Supercap2F/Smart-Watch/KiCAD/SmartWatchBOM.xls

Smart Watch BOM
Ref | ESR | Value | Type | Volts | Part No. | DigiKey Part No. | Qt. | Qt. Ex. | Price Ea. | Price Total | Package
BT1 |  | LiPoly 1S1P |  |  |  | - | 1 |  | $0.00 | $0.00 | 603
C36 C37 |  | 9p1 |  |  |  | 1276-2353-1-ND | 2 |  | $0.10 | $0.20 | 603
C34 C35 |  | 15p |  |  |  | 1276-1296-1-ND | 2 |  | $0.10 | $0.20 | 603
C4 |  | 27p |  |  |  | 1276-1086-1-ND | 1 |  | $0.10 | $0.10 | 603
C12 C13 |  | 47p |  |  |  | 1276-1037-1-ND | 2 |  | $0.10 | $0.20 | 603
C5 |  | 180p |  |  |  | 1276-1255-1-ND | 1 |  | $0.10 | $0.10 | 603
C6 C10 C11 C14 C16 C20 C21 C22 C23 C26 C27 C28 C29 C30 C31 C33 |  | 100n |  |  |  | 311-1343-1-ND | 16 | 9 | $0.01 | $0.32 | 603
C7 C18 C24 |  | 1u |  |  |  | 311-1372-1-ND | 3 | 7 | $0.03 | $0.33 | 603
C2 C9 C19 C25 |  | 4.7u |  |  |  | 478-8656-1-ND | 4 | 1 | $0.77 | $3.85 | 603
C17 |  | 4.7u | tan | 25 |  | 478-8508-1-ND | 1 | 1 | $0.86 | $1.72 | 805
C1 C3 C15 |  | 10u |  |  |  | 718-1118-1-ND | 3 | 1 | $0.31 | $1.24 | 1206
C8 |  | 10u | X5R |  |  | 1276-6457-1-ND | 1 | 1 | $0.10 | $0.20 | 805
C32 | <3R | 10u | tan | 6 |  | 478-8193-1-ND | 1 | 1 | $0.34 | $0.68 | 1206
I1 |  | 10uH |  |  |  | 445-6396-1-ND | 1 | 8 | $0.14 | $1.26
I2 |  | 10uH |  |  |  | 445-6396-1-ND | 1 |  | $0.14 | $0.14
M1 |  | MOTOR |  |  |  |  | 1 |  | $0.00 | $0.00
P1 |  | CONN_5 |  |  |  | 609-4613-1-ND | 1 | 1 | $0.46 | $0.92
Q1 |  | NPN |  |  |  |  | 1 |  | $0.00 | $0.00
R2 R3 |  | 0R |  |  | have some |  | 2 |  | $0.00 | $0.00 | 603
R8 R9 |  | 27R |  |  |  | 311-27GRCT-ND | 2 | 8 | $0.01 | $0.11 | 603
R1 R14 |  | 1K |  |  |  | 311-1.0KGRCT-ND | 2 | 8 | $0.01 | $0.11 | 603
R7 |  | 2K8 |  |  |  | 311-2.80KHRCT-ND | 1 | 9 | $0.01 | $0.14 | 603
R10 |  | 4K7 |  |  |  | 311-4.7KGRCT-ND | 1 | 9 | $0.01 | $0.11 | 603
R11 R13 R15 R16 R17 R18 R19 |  | 10K |  |  |  | 311-10KGRCT-ND | 7 | 3 | $0.01 | $0.11 | 603
R6 |  | 27K |  |  |  | 311-27KGRCT-ND | 1 | 9 | $0.01 | $0.12 | 603
R5 |  | 100K |  |  |  | 311-100KGRCT-ND | 1 | 9 | $0.01 | $0.11 | 603
R4 R12 |  | 560K |  |  |  | A102294CT-ND | 2 | 1 | $0.63 | $1.89 | 603
SW1 SW2 SW3 SW4 |  | SW_PUSH |  |  |  | 732-7059-1-ND | 4 | 2 | $0.54 | $3.24
TP1 TP2 TP3 TP4 TP5 TP6 TP7 TP8 TP9 TP10 TP11 |  | TP |  |  | Free! |  | 11 |  | $0.00 | $0.00
U1 |  | BQ25010 |  |  |  | 296-17639-1-ND | 1 |  | $3.87 | $3.87
U2 |  | MIC2290 |  |  |  | 576-1076-1-ND | 1 |  | $0.82 | $0.82
U4 |  | EROLED015-1 |  |  | get from buydisplays.com |  | 1 |  | $0.00 | $0.00
U5 |  | FXOS8700CQ |  |  |  | FXOS8700CQR1CT-ND | 1 |  | $2.63 | $2.63
U6 |  | PIC32MX370F512H |  |  | buy from microchip $14+ |  | 1 |  | $0.00 | $0.00
U3 |  | FT201X |  |  |  | 768-1131-1-ND | 1 |  | $2.30 | $2.30
X2 |  | 32.768KHz |  |  | 9HT10-32.768KBZC-T | 887-2604-1-ND | 1 | 1 | $0.59 | $1.18
X1 |  | 25MHz |  |  | ABM8-25.000MHZ-D2Y-T | 535-13419-1-ND | 1 | 1 | $0.46 | $0.92
 |  |  |  |  |  |  |  |  | Total: | $29.12
