Supercap2F/Smart-Watch/3D-Models/BoN-Jig/JigPrint001.stl

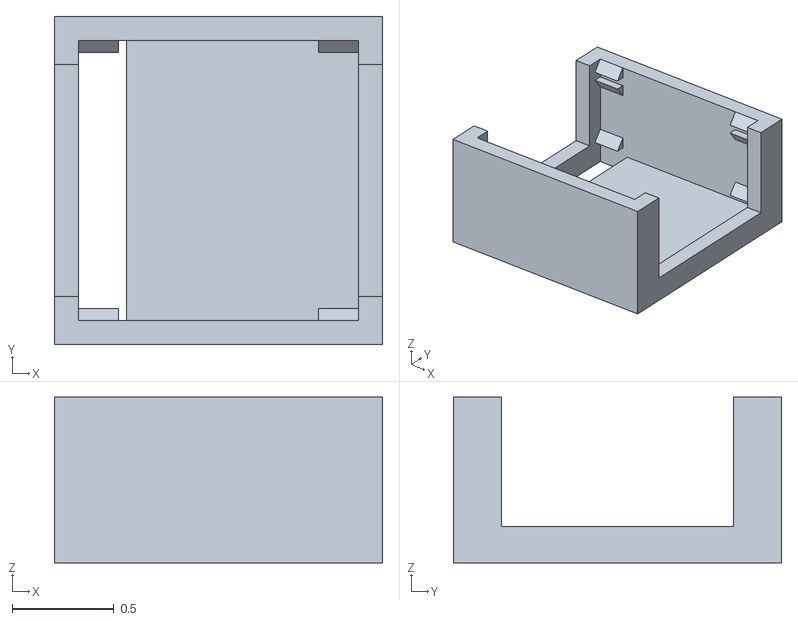
[picture p1: CAD file, 2016-07-14]
3D-Models/BoN-Jig/JigPrint001.stl
1.61 x 1.61 x 0.815
