Supercap2F/Smart-Watch/3D-Models/BoN-Jig/JigPrint001 - Jig (repaired).stl

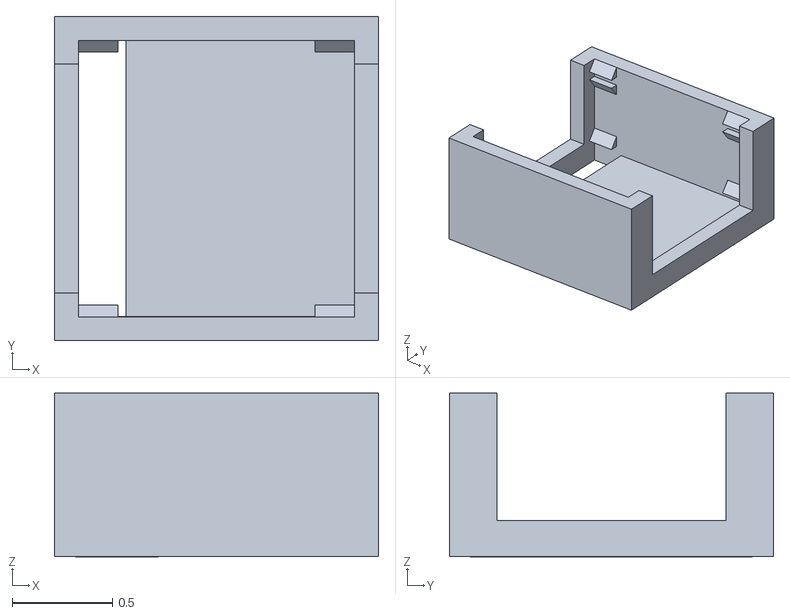
[picture p3: CAD file, 2016-07-14]
3D-Models/BoN-Jig/JigPrint001 - Jig (repaired).stl
1.62 x 1.62 x 0.816
