Supercap2F/Smart-Watch/(list of files, cad)

Other CAD files:
3D-Models/BoN-Jig/Jig.skp
