Supercap2F/Smart-Watch/KiCAD/SmartWatch.pdf

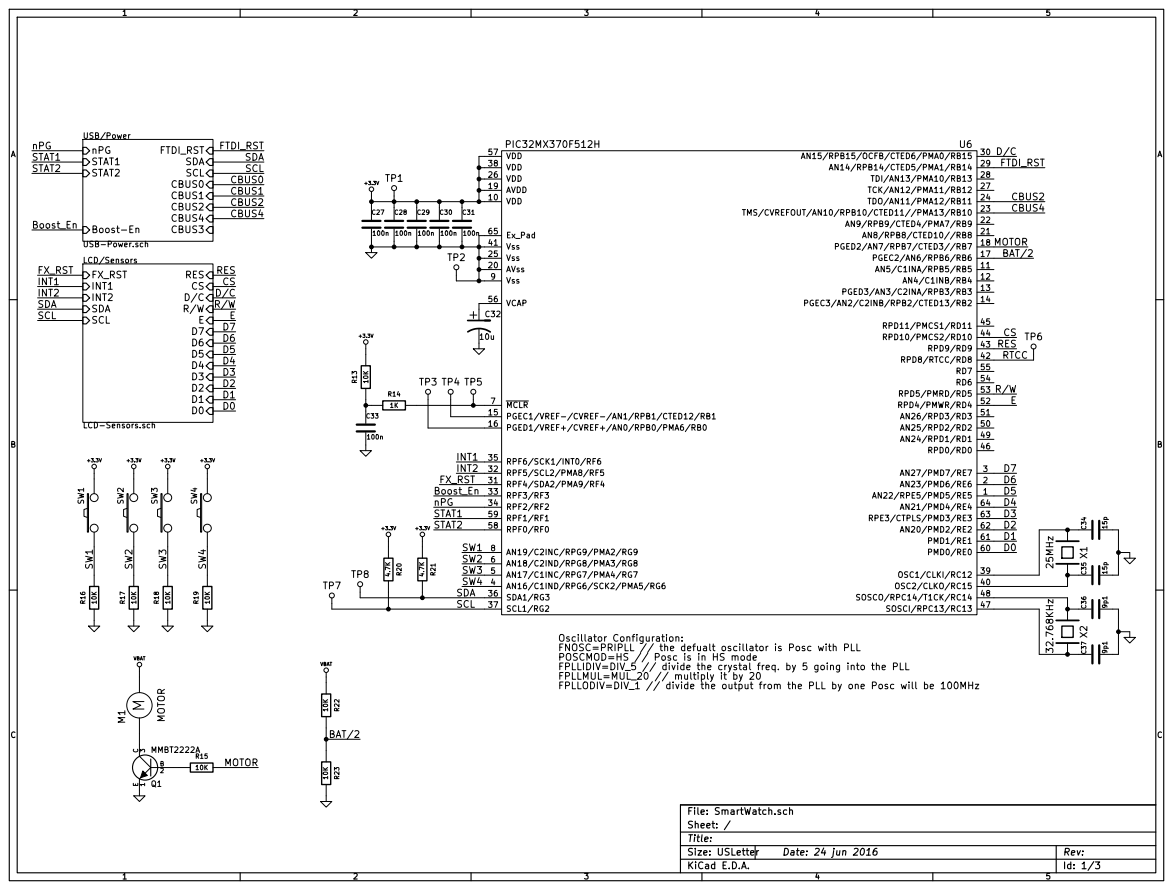
[picture p4: page 1]

Oscillator Configuration:
FNOSC=PRIPLL // the defualt oscillator is Posc with PLL
POSCMOD=HS // Posc is in HS mode
FPLLIDIV=DIV_5 // divide the crystal freq. by 5 going into the PLL
FPLLMUL=MUL_20 // multiply it by 20

Id: 1/3 Title: File: SmartWatch.sch
Sheet: /

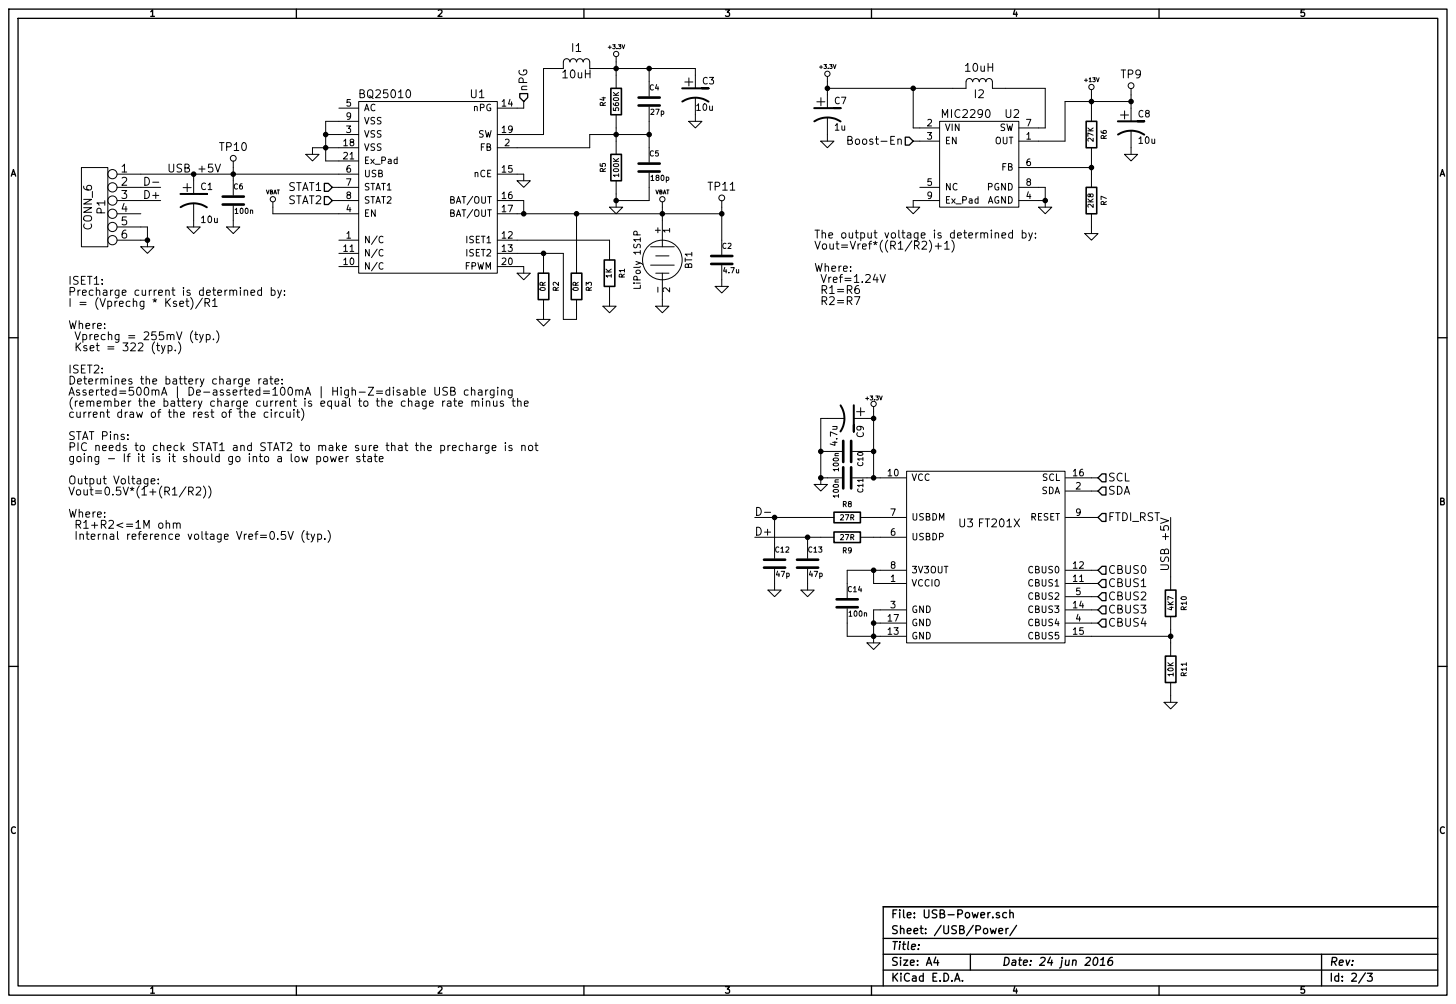
[picture p5: page 2]

+3.3V The output voltage is determined by:

Precharge current is determined by:
I = (Vprechg * Kset)/R1 Where:

Vprechg = 255mV (typ.)
Kset = 322 (typ.)
ISET2:
Determines the battery charge rate:
Asserted=500mA | De-asserted=100mA | High-Z=disable USB charging
(remember the battery charge current is equal to the chage rate minus the
current draw of the rest of the circuit)
STAT Pins:
PIC needs to check STAT1 and STAT2 to make sure that the precharge is not
going - If it is it should go into a low power state
Output Voltage:
Vout=0.5V*(1+(R1/R2)) Where:

Id: 2/3 Title: File: USB-Power.sch
Sheet: /USB/Power/

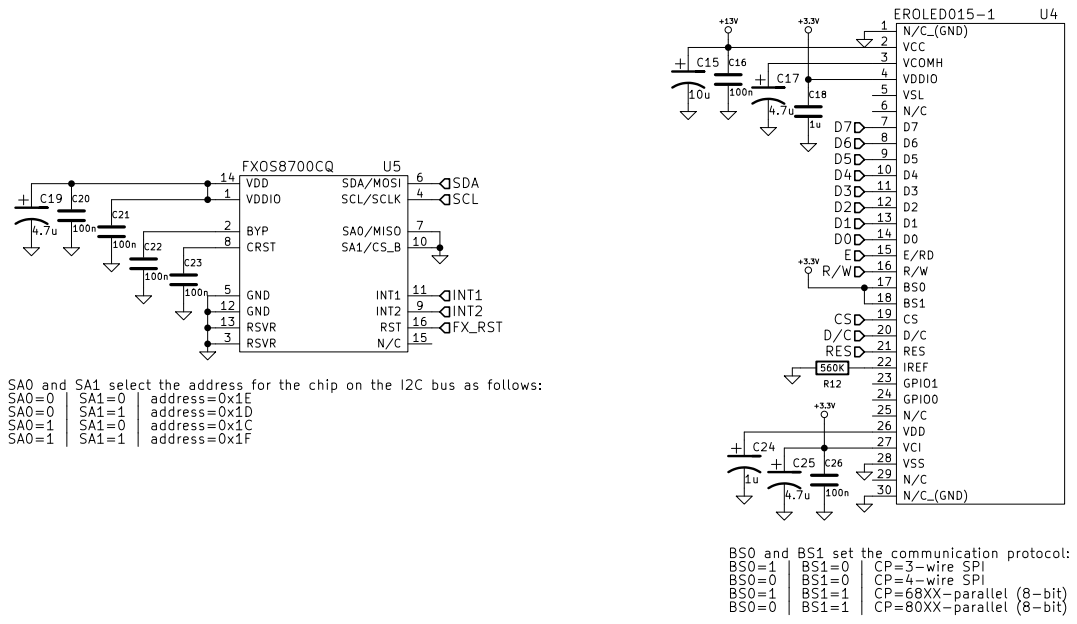
[picture p6: page 3]

SA0 and SA1 select the address for the chip on the I2C bus as follows:
SA0=0 | SA1=0 | address=0x1E
SA0=0 | SA1=1 | address=0x1D
SA0=1 | SA1=0 | address=0x1C
SA0=1 | SA1=1 | address=0x1F

Id: 3/3 Title: File: LCD-Sensors.sch
Sheet: /LCD/Sensors/
