Supercap2F/Smart-Watch/KiCAD/SmartWatch.kicad_pcb

## KiCad design KiCAD/SmartWatch.kicad_pcb (2016-07-19)

Schematic: SmartWatch.sch

Parts:
C27, C28, C29, C30, C31, C33: 100n
C32: 10u; Voltage 6
C34, C35: 15p
C36, C37: 9p1
M1: MOTOR
Q1: MMBT2222A
R13, R15, R16, R17, R18, R19, R22, R23: 10K
R14: 1K
R20, R21: 4.7K
SW1, SW2, SW3, SW4: SW_PUSH
TP1, TP2, TP3, TP4, TP5, TP6, TP7, TP8: TP
U6: PIC32MX370F512H
X1: 25MHz
X2: 32.768KHz

Connections:
+3.3V: C27.1, C28.1, C29.1, C30.1, C31.1, R13.2, R20.1, R21.1, SW1.2, SW2.2, SW3.2, SW4.2, TP1.1, U6.10 (VDD), U6.19 (AVDD), U6.26 (VDD), U6.38 (VDD), U6.57 (VDD); also elsewhere on the board
/BAT/2: R22.2, R23.1, U6.17 (PGEC2/AN6/RPB6/RB6)
/LCD/Sensors/CS: U6.44 (RPD10/PMCS2/RD10); also elsewhere on the board
/LCD/Sensors/D0: U6.60 (PMD0/RE0); also elsewhere on the board
/LCD/Sensors/D1: U6.61 (PMD1/RE1); also elsewhere on the board
/LCD/Sensors/D2: U6.62 (AN20/PMD2/RE2); also elsewhere on the board
/LCD/Sensors/D3: U6.63 (RPE3/CTPLS/PMD3/RE3); also elsewhere on the board
/LCD/Sensors/D4: U6.64 (AN21/PMD4/RE4); also elsewhere on the board
/LCD/Sensors/D5: U6.1 (AN22/RPE5/PMD5/RE5); also elsewhere on the board
/LCD/Sensors/D6: U6.2 (AN23/PMD6/RE6); also elsewhere on the board
/LCD/Sensors/D7: U6.3 (AN27/PMD7/RE7); also elsewhere on the board
/LCD/Sensors/D/C: U6.30 (AN15/RPB15/OCFB/CTED6/PMA0/RB15); also elsewhere on the board
/LCD/Sensors/E: U6.52 (RPD4/PMWR/RD4); also elsewhere on the board
/LCD/Sensors/FX_RST: U6.31 (RPF4/SDA2/PMA9/RF4); also elsewhere on the board
/LCD/Sensors/INT1: U6.35 (RPF6/SCK1/INT0/RF6); also elsewhere on the board
/LCD/Sensors/INT2: U6.32 (RPF5/SCL2/PMA8/RF5); also elsewhere on the board
/LCD/Sensors/R/W: U6.53 (RPD5/PMRD/RD5); also elsewhere on the board
/LCD/Sensors/RES: U6.43 (RPD9/RD9); also elsewhere on the board
/LCD/Sensors/SCL: R20.2, TP7.1, U6.37 (SCL1/RG2); also elsewhere on the board
/LCD/Sensors/SDA: R21.2, TP8.1, U6.36 (SDA1/RG3); also elsewhere on the board
/MOTOR: R15.2, U6.18 (PGED2/AN7/RPB7/CTED3//RB7)
/RTCC: TP6.1, U6.42 (RPD8/RTCC/RD8)
/SW1: R16.2, SW1.1, U6.8 (AN19/C2INC/RPG9/PMA2/RG9)
/SW2: R17.2, SW2.1, U6.6 (AN18/C2IND/RPG8/PMA3/RG8)
/SW3: R18.2, SW3.1, U6.5 (AN17/C1INC/RPG7/PMA4/RG7)
/SW4: R19.2, SW4.1, U6.4 (AN16/C1IND/RPG6/SCK2/PMA5/RG6)
/USB/Power/Boost-En: U6.33 (RPF3/RF3); also elsewhere on the board
/USB/Power/CBUS2: U6.24 (TDO/AN11/PMA12/RB11); also elsewhere on the board
/USB/Power/CBUS4: U6.23 (TMS/CVREFOUT/AN10/RPB10/CTED11//PMA13/R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); also elsewhere on the board
/USB/Power/FTDI_RST: U6.29 (AN14/RPB14/CTED5/PMA1/RB14); also elsewhere on the board
/USB/Power/STAT1: U6.59 (RPF1/RF1); also elsewhere on the board
/USB/Power/STAT2: U6.58 (RPF0/RF0); also elsewhere on the board
/USB/Power/nPG: U6.34 (RPF2/RF2); also elsewhere on the board
GND: C27.2, C28.2, C29.2, C30.2, C31.2, C32.2, C33.2, C34.2, C35.2, C36.2, C37.2, Q1.1 (E), R16.1, R17.1, R18.1, R19.1, R23.2, TP2.1, U6.9 (Vss), U6.20 (AVss), U6.25 (Vss), U6.41 (Vss), U6.65 (Ex_Pad), X1.3, X1.4; also elsewhere on the board
unnamed: C34.1, U6.39 (OSC1/CLKI/RC12), X1.2
unnamed: C35.1, U6.40 (OSC2/CLKO/RC15), X1.1
unnamed: TP3.1, U6.16 (PGED1/VREF+/CVREF+/AN0/RPB0/PMA6/RB0)
unnamed: TP4.1, U6.15 (PGEC1/VREF-/CVREF-/AN1/RPB1/CTED12/RB1)
unnamed: C33.1, R13.1, R14.1
unnamed: C36.1, U6.48 (SOSCO/RPC14/T1CK/RC14), X2.2
unnamed: C37.1, U6.47 (SOSCI/RPC13/RC13), X2.1
unnamed: Q1.2 (B), R15.1
unnamed: M1.1, Q1.3 (C)
unnamed: R14.2, TP5.1, U6.7 (~MCLR)
unnamed: C32.1, U6.56 (VCAP)
VBAT: R22.1; also elsewhere on the board

Notes on the sheet:
Oscillator Configuration: FNOSC=PRIPLL // the defualt oscillator is Posc with PLL POSCMOD=HS // Posc is in HS mode FPLLIDIV=DIV_5 // divide the crystal freq. by 5 going into the PLL FPLLMUL=MUL_20 // multiply it by 20 FPLLODIV=DIV_1 // divide the output from the PLL by one Posc will be 100MHz

Schematic: USB-Power.sch

Parts:
BT1: LiPoly 1S1P
C1, C3, C8: 10u
C2, C9: 4.7u
C4: 27p
C5: 180p
C6, C10, C11, C14: 100n
C7: 1u
C12, C13: 47p
I1: 10uH
I2: 10uH
P1: CONN_6
R1: 1K
R2, R3: 0R
R4: 560K
R5: 100K
R6: 27K
R7: 2K8
R8, R9: 27R
R10: 4K7
R11: 10K
TP9, TP10, TP11: TP
U1: BQ25010
U2: MIC2290
U3: FT201X

Connections:
+3.3V: C3.1, C4.1, C7.1, C9.1, C10.1, C11.1, I1.2, I2.1, R4.2, U2.2 (VIN), U3.10 (VCC); also elsewhere on the board
+13V: C8.1, R6.1, TP9.1, U2.1 (OUT); also elsewhere on the board
/LCD/Sensors/SCL: U3.16 (SCL); also elsewhere on the board
/LCD/Sensors/SDA: U3.2 (SDA); also elsewhere on the board
/USB/Power/Boost-En: U2.3 (EN); also elsewhere on the board
/USB/Power/CBUS2: U3.5 (CBUS2); also elsewhere on the board
/USB/Power/CBUS4: U3.4 (CBUS4); also elsewhere on the board
/USB/Power/D+: C13.1, P1.3, R9.1
/USB/Power/D-: C12.1, P1.2, R8.1
/USB/Power/FTDI_RST: U3.9 (RESET); also elsewhere on the board
/USB/Power/STAT1: U1.7 (STAT1); also elsewhere on the board
/USB/Power/STAT2: U1.8 (STAT2); also elsewhere on the board
/USB/Power/USB +5V: C1.1, C6.1, P1.1, R10.2, TP10.1, U1.6 (USB)
/USB/Power/nPG: U1.14 (nPG); also elsewhere on the board
GND: BT1.2 (-), C1.2, C2.2, C3.2, C5.2, C6.2, C7.2, C8.2, C9.2, C10.2, C11.2, C12.2, C13.2, C14.2, P1.5, P1.6, R1.2, R2.2, R5.1, R7.2, R11.1, U1.3 (VSS), U1.9 (VSS), U1.15 (nCE), U1.18 (VSS), U1.20 (FPWM), U1.21 (Ex_Pad), U2.4 (AGND), U2.8 (PGND), U2.9 (Ex_Pad), U3.3 (GND), U3.13 (GND), U3.17 (GND); also elsewhere on the board
unnamed: I1.1, U1.19 (SW)
unnamed: C4.2, C5.1, R4.1, R5.2, U1.2 (FB)
unnamed: I2.2, U2.7 (SW)
unnamed: R2.1, R3.2, U1.13 (ISET2)
unnamed: R1.1, U1.12 (ISET1)
unnamed: R10.1, R11.2, U3.15 (CBUS5)
unnamed: C14.1, U3.1 (VCCIO), U3.8 (3V3OUT)
unnamed: R9.2, U3.6 (USBDP)
unnamed: R6.2, R7.1, U2.6 (FB)
unnamed: R8.2, U3.7 (USBDM)
VBAT: BT1.1 (+), C2.1, R3.1, TP11.1, U1.4 (EN), U1.16 (BAT/OUT), U1.17 (BAT/OUT); also elsewhere on the board

Notes on the sheet:
ISET1: Precharge current is determined by: I = (Vprechg * Kset)/R1 Where: Vprechg = 255mV (typ.) Kset = 322 (typ.) ISET2: Determines the battery charge rate: Asserted=500mA | De-asserted=100mA | High-Z=disable USB charging (remember the battery charge current is equal to the chage rate minus the cu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
The output voltage is determined by: Vout=Vref*((R1/R2)+1) Where: Vref=1.24V R1=R6 R2=R7

Schematic: LCD-Sensors.sch

Parts:
C15: 10u
C16, C20, C21, C22, C23, C26: 100n
C17: 4.7u; Voltage 25
C18, C24: 1u
C19, C25: 4.7u
R12: 560K
U4: EROLED015-1
U5: FXOS8700CQ

Connections:
+3.3V: C18.1, C25.1, C26.1, U4.4 (VDDIO), U4.17 (BS0), U4.18 (BS1), U4.27 (VCI); also elsewhere on the board
+13V: C15.1, C16.1, U4.2 (VCC); also elsewhere on the board
/LCD/Sensors/CS: U4.19 (CS); also elsewhere on the board
/LCD/Sensors/D0: U4.14 (D0); also elsewhere on the board
/LCD/Sensors/D1: U4.13 (D1); also elsewhere on the board
/LCD/Sensors/D2: U4.12 (D2); also elsewhere on the board
/LCD/Sensors/D3: U4.11 (D3); also elsewhere on the board
/LCD/Sensors/D4: U4.10 (D4); also elsewhere on the board
/LCD/Sensors/D5: U4.9 (D5); also elsewhere on the board
/LCD/Sensors/D6: U4.8 (D6); also elsewhere on the board
/LCD/Sensors/D7: U4.7 (D7); also elsewhere on the board
/LCD/Sensors/D/C: U4.20 (D/C); also elsewhere on the board
/LCD/Sensors/E: U4.15 (E/RD); also elsewhere on the board
/LCD/Sensors/FX_RST: U5.16 (RST); also elsewhere on the board
/LCD/Sensors/INT1: U5.11 (INT1); also elsewhere on the board
/LCD/Sensors/INT2: U5.9 (INT2); also elsewhere on the board
/LCD/Sensors/R/W: U4.16 (R/W); also elsewhere on the board
/LCD/Sensors/RES: U4.21 (RES); also elsewhere on the board
/LCD/Sensors/SCL: U5.4 (SCL/SCLK); also elsewhere on the board
/LCD/Sensors/SDA: U5.6 (SDA/MOSI); also elsewhere on the board
GND: C15.2, C16.2, C17.2, C18.2, C19.2, C20.2, C21.2, C22.2, C23.2, C24.2, C25.2, C26.2, R12.1, U4.1 (N/C_(GND)), U4.28 (VSS), U4.30 (N/C_(GND)), U5.3 (RSVR), U5.5 (GND), U5.7 (SA0/MISO), U5.10 (SA1/CS_B), U5.12 (GND), U5.13 (RSVR); also elsewhere on the board
unnamed: C19.1, C20.1, C21.1, U5.1 (VDDIO), U5.14 (VDD)
unnamed: C22.1, U5.2 (BYP)
unnamed: C23.1, U5.8 (CRST)
unnamed: R12.2, U4.22 (IREF)
unnamed: C24.1, U4.26 (VDD)
unnamed: C17.1, U4.3 (VCOMH)

Notes on the sheet:
SA0 and SA1 select the address for the chip on the I2C bus as follows: SA0=0 | SA1=0 | address=0x1E SA0=0 | SA1=1 | address=0x1D SA0=1 | SA1=0 | address=0x1C SA0=1 | SA1=1 | address=0x1F
BS0 and BS1 set the communication protocol: BS0=1 | BS1=0 | CP=3-wire SPI BS0=0 | BS1=0 | CP=4-wire SPI BS0=1 | BS1=1 | CP=68XX-parallel (8-bit) BS0=0 | BS1=1 | CP=80XX-parallel (8-bit)

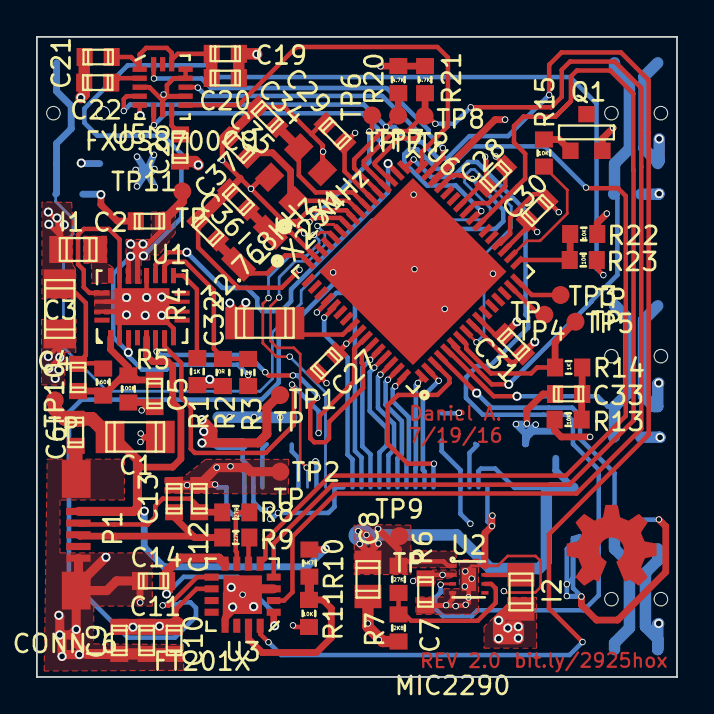
[picture p7: board SmartWatch.kicad_pcb from above]

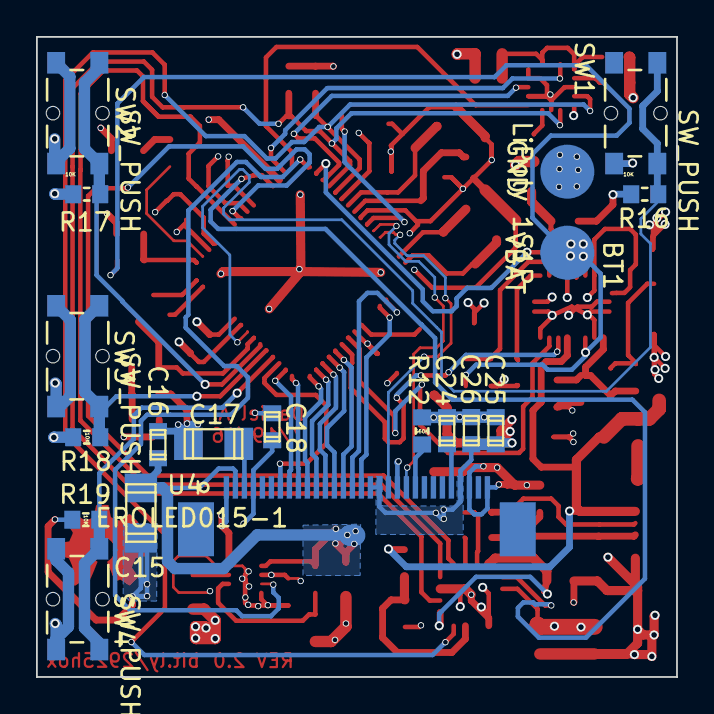
[picture p8: board SmartWatch.kicad_pcb from below]

Board: 4 copper layers, 35.6 x 35.6 mm, 88 parts (18 on the bottom side), 65 nets.
