Supercap2F/Smart-Watch/KiCAD/BON-PCB/BON-PCB.kicad_pcb

## KiCad design KiCAD/BON-PCB/BON-PCB.kicad_pcb (2016-07-14)

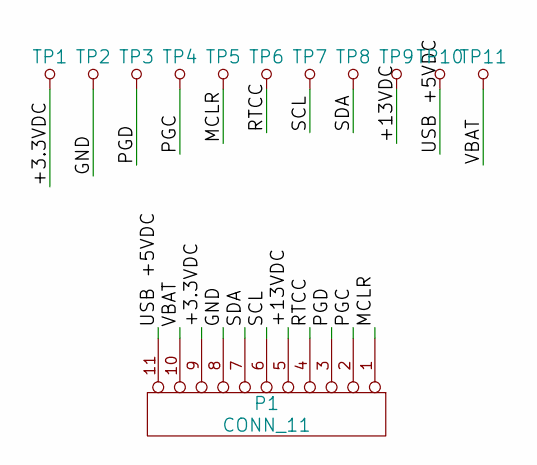
[picture p9: schematic BON-PCB.sch]

Parts:
P1: CONN_11
TP1: 3.3VDC
TP2: GND
TP3: PGD
TP4: PGC
TP5: MCLR
TP6: RTCC
TP7: SCL
TP8: SDA
TP9: +13VDC
TP10: USB +5VDC
TP11: VBAT

Connections:
/+3.3VDC: P1.9, TP1.1
/+13VDC: P1.5, TP9.1
/GND: P1.8, TP2.1
/MCLR: P1.1, TP5.1
/PGC: P1.2, TP4.1
/PGD: P1.3, TP3.1
/RTCC: P1.4, TP6.1
/SCL: P1.6, TP7.1
/SDA: P1.7, TP8.1
/USB +5VDC: P1.11, TP10.1
/VBAT: P1.10, TP11.1

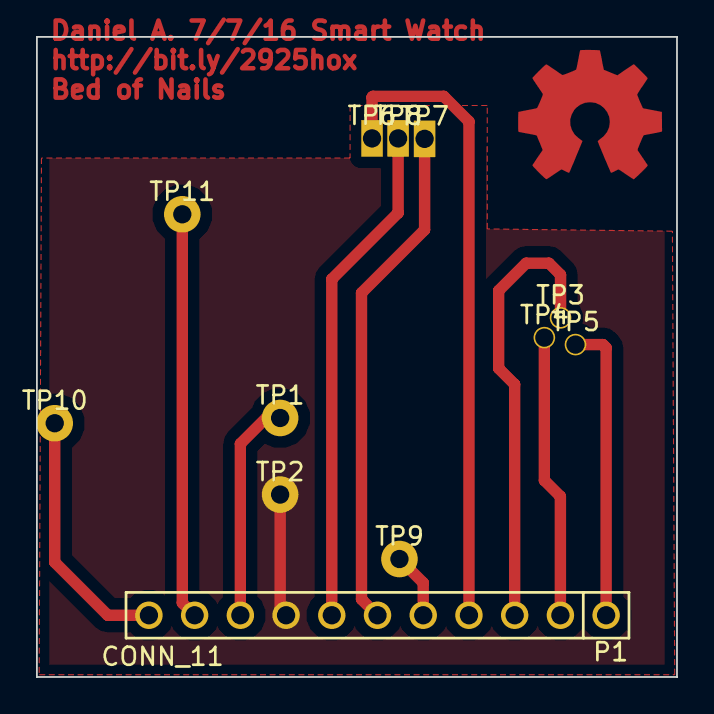
[picture p10: board BON-PCB.kicad_pcb from above]

Board: 2 copper layers, 35.6 x 35.6 mm, 12 parts (0 on the bottom side), 11 nets.
