Supercap2F/Smart-Watch/SmartWatch.X/init_sys.h

/******************************************************************************/
/* File:   init_sys.h                                                         */
/* Author: Supercap2F                                                         */
/*                                                                            */
/* Created on August 04, 2016, 5:36 PM                                        */
/******************************************************************************/
#ifndef INIT_SYS_H
#define	INIT_SYS_H

/******************************************************************************/
/* Function: init_io_ports                                                    */
/******************************************************************************/
void init_io_ports(void);

#endif	/* INIT_PORTS_H */
