Supercap2F/Smart-Watch/(commit log)

2016-06-27 Finished PCB
    [SmartWatch.kicad_pcb]
2016-06-27 Updated PCB
    [SmartWatch.kicad_pcb]
2016-06-27 Updated Front Paste On PCB
    [SmartWatch.kicad_pcb]
2016-07-14 Added Files for Bed-of-Nails
    [BON-PCB.kicad_pcb, BON-PCB.sch, BoN-xy.xls, Jig.skp, JigPrint001 - Jig (repaired).stl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]
2016-07-19 Finished PCB Rev 2.0
    [SmartWatch.kicad_pcb]
2016-08-02 Added PDF schematic
2016-08-15 Worked out code bugs
    [LCD-Sensors.sch, SmartWatch.sch, USB-Power.sch]
